gepid-upf/myb/docs/schematic/wearable.brd

## EAGLE design docs/schematic/wearable.brd (2019-07-02)

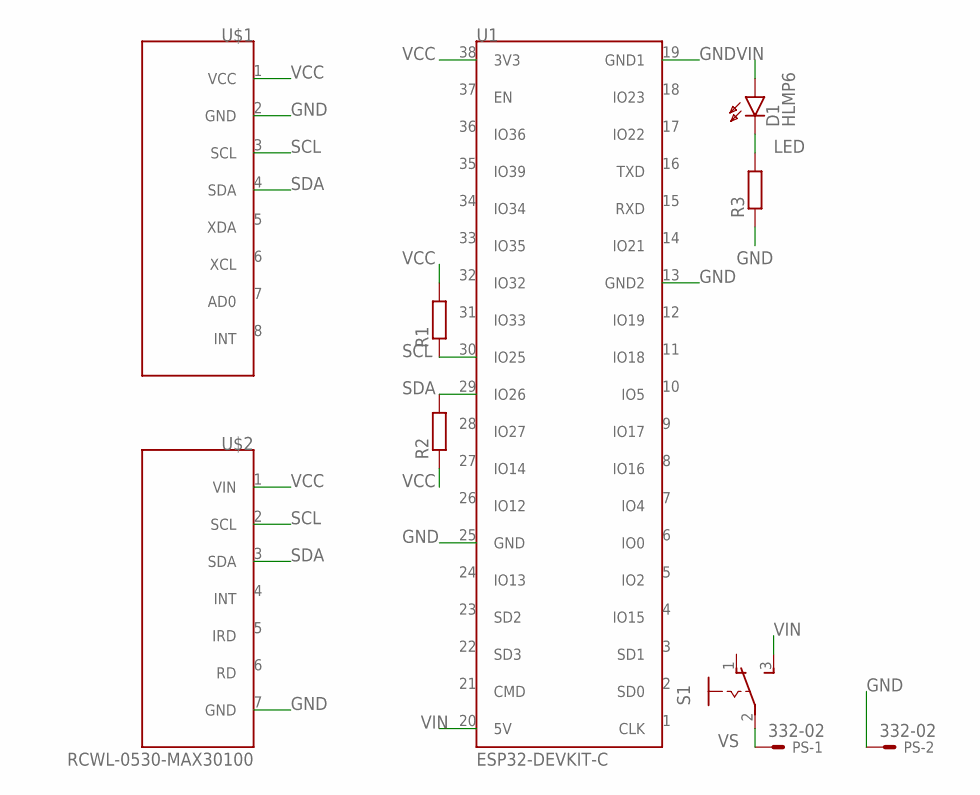
[picture p2: schematic wearable.sch]

Parts:
D1: HLMP6
PS: 332-02
R1, R2, R3: R-EU_0207/10; 0207/10
S1: 255SB
U1: ESP32-DEVKIT-C; ESP32
U$1: GY-521-MPU-6050; GY-521
U$2: RCWL-0530-MAX30100; RCWL-0530

Connections:
GND: PS.2, R3.1, U1.13 (GND2), U1.19 (GND1), U1.25 (GND), U$1.2 (GND), U$2.7 (GND)
LED: D1.K, R3.2
SCL: R1.1, U1.30 (IO25), U$1.3 (SCL), U$2.2 (SCL)
SDA: R2.2, U1.29 (IO26), U$1.4 (SDA), U$2.3 (SDA)
VCC: R1.2, R2.1, U1.38 (3V3), U$1.1 (VCC), U$2.1 (VIN)
VIN: D1.A, S1.3 (S), U1.20 (5V)
VS: PS.1, S1.2

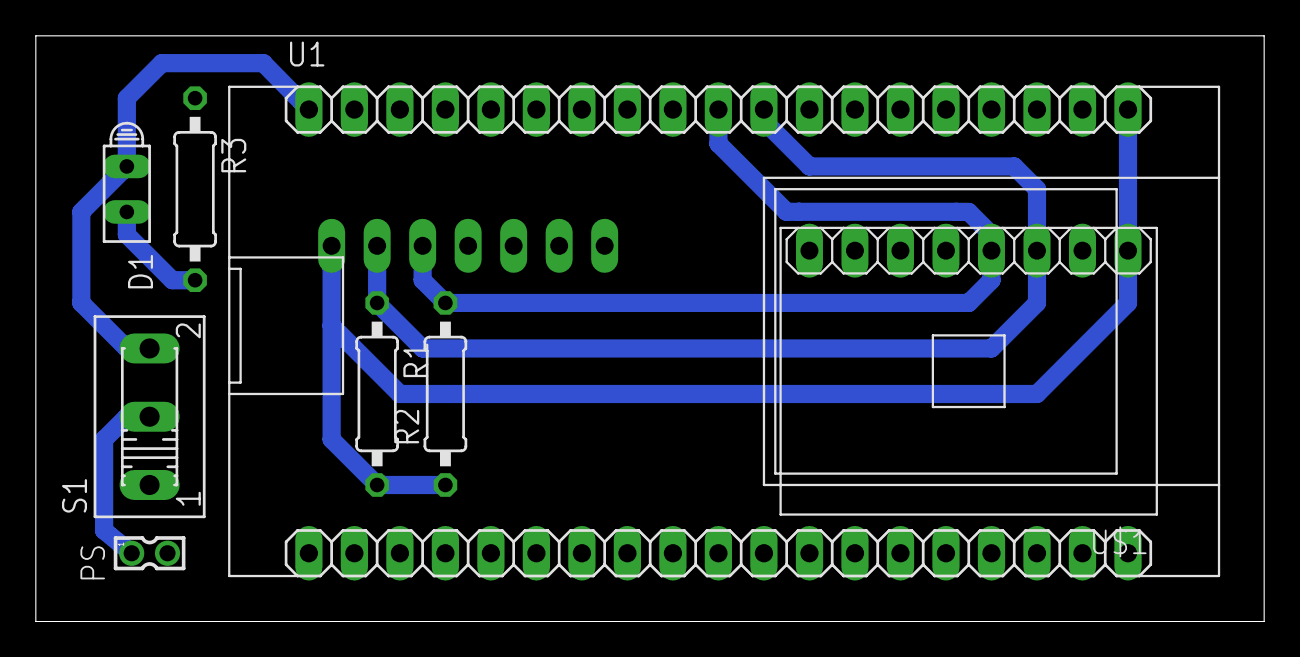
[picture p3: board wearable.brd from above]

Board: 2 copper layers, 68.6 x 32.7 mm, 9 parts (1 on the bottom side), 7 nets.
