gepid-upf/myb/(commit log)

2019-04-25 Fixed errors with the SPIFFS.
    [main.c]
2019-05-02 Fixed SPIFFS and log messages.
    [main.c]
2019-05-09 Added partitions.csv.
    [partitions.csv]
2019-05-09 fix copyright to 2019
    [main.c]
2019-05-20 Added wiring image.
2019-07-02 Add schematic.
    [wearable.brd, wearable.sch]
